ryancblocker/sports-ticker/case/reference/Cheap Yellow Display v16.step

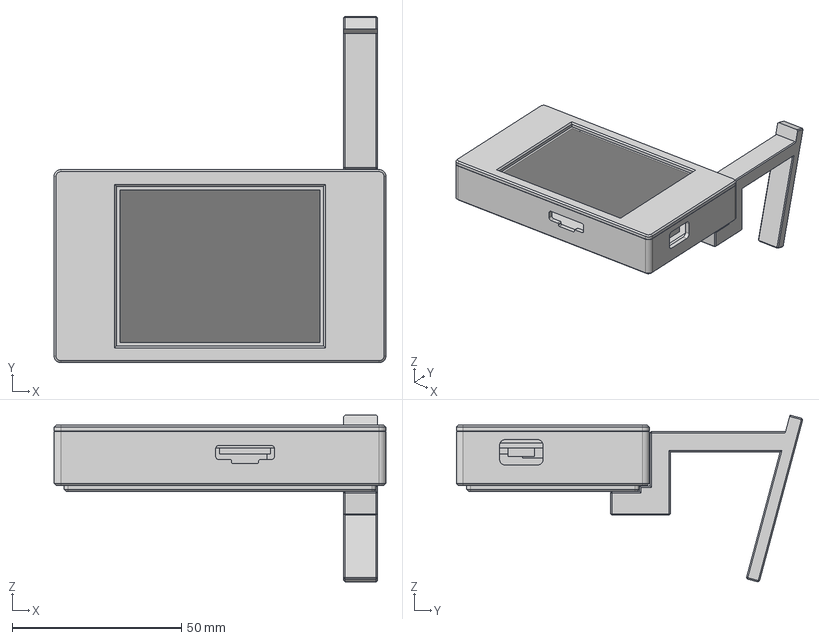
[picture p1: CAD file, 2026-11-10]
case/reference/Cheap Yellow Display v16.step
98.0 x 102.3 x 49.2 mm
Display
case front
case rear
case back panel
case foot
