ryancblocker/sports-ticker/case/stl/SportsTicker_PodBack.stl

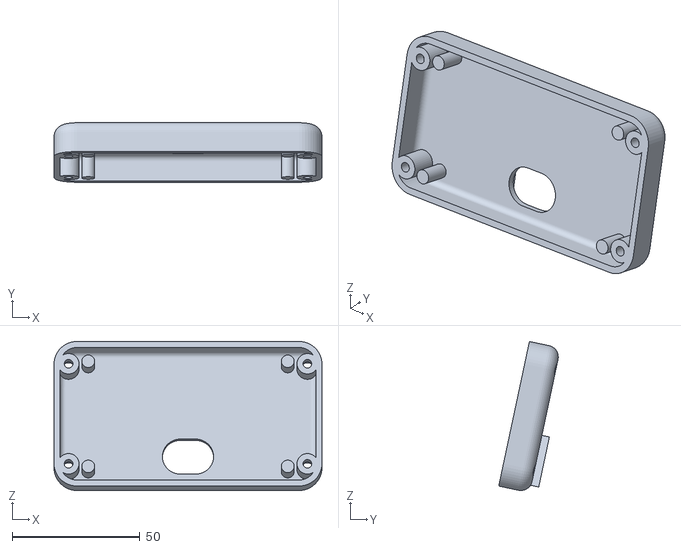
[picture p2: CAD file, 2026-11-10]
case/stl/SportsTicker_PodBack.stl
104.8 x 23.3 x 58.3
