ryancblocker/sports-ticker/makerworld/SportsTickerFinal.3mf

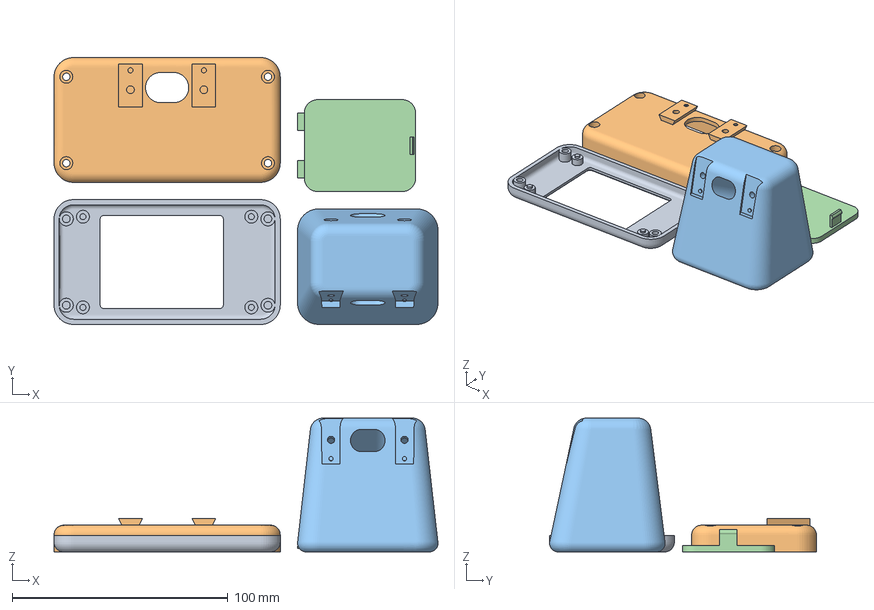
[picture p3: CAD file, 2026-11-10]
makerworld/SportsTickerFinal.3mf
177.8 x 123.6 x 62.0 mm
Pod Front (face down)
Pod Back (rails up)
Base (upright)
Penny Lid
