ryancblocker/sports-ticker/SportsTickerFinal.3mf

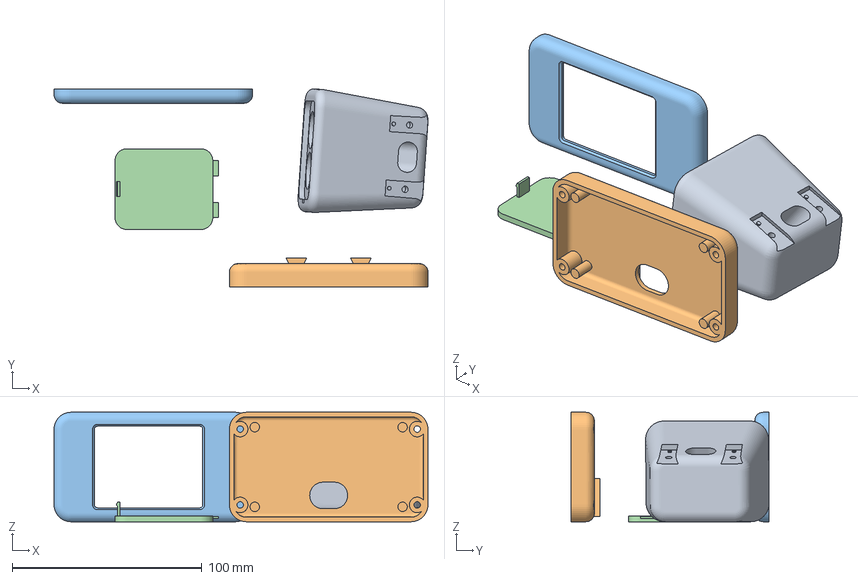
[picture p4: CAD file, 2026-11-10]
SportsTickerFinal.3mf
197.3 x 104.6 x 57.8 mm
Base (upright)
Pod Back (rails up)
Pod Front (face down)
Penny Lid
