ryancblocker/sports-ticker/case/stl/SportsTicker_Base.stl

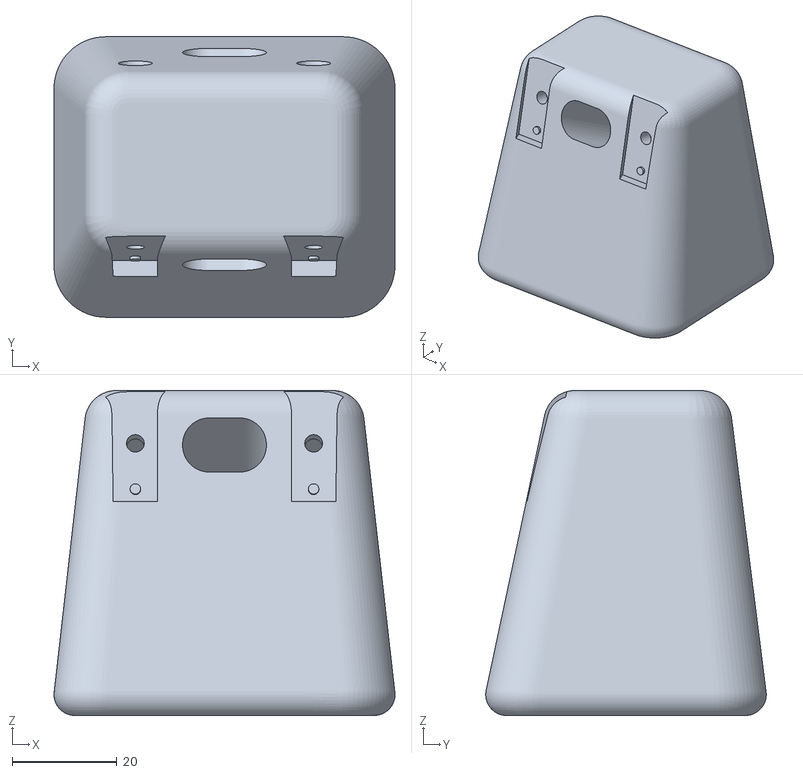
[picture p5: CAD file, 2026-11-10]
case/stl/SportsTicker_Base.stl
65.0 x 53.5 x 62.0
