ryancblocker/sports-ticker/test-print/SportsTicker_BaseAndLid.3mf

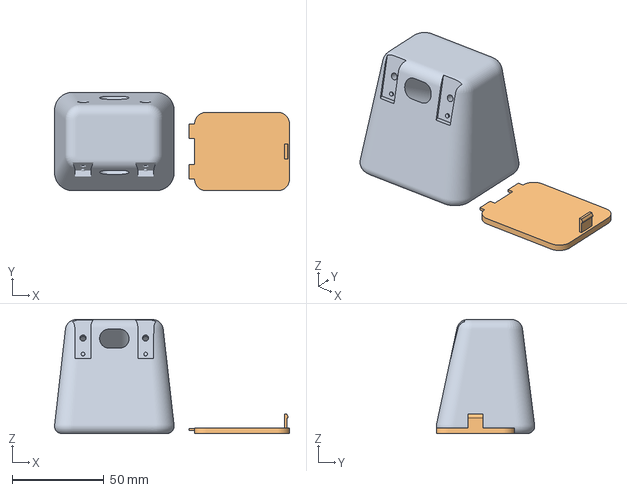
[picture p6: CAD file, 2026-11-10]
test-print/SportsTicker_BaseAndLid.3mf
127.7 x 53.5 x 62.0 mm
Base (upright)
Penny Lid
