ryancblocker/sports-ticker/case/stl/SportsTicker_PodFront.stl

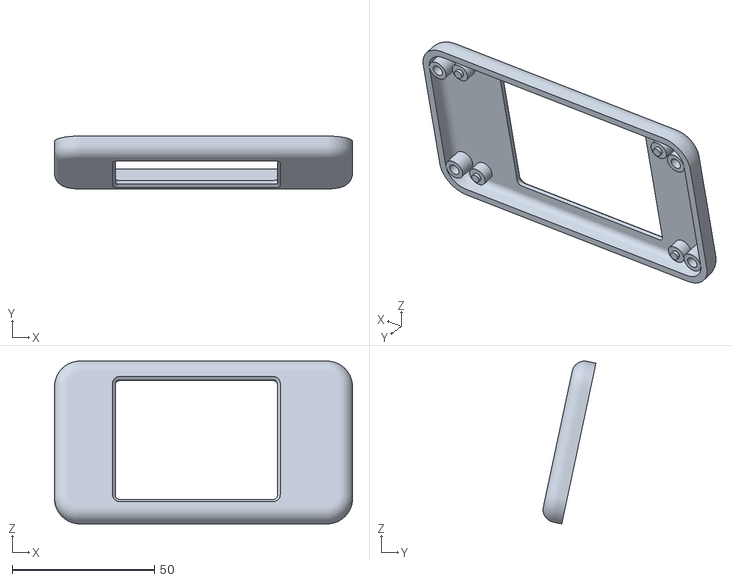
[picture p7: CAD file, 2026-11-10]
case/stl/SportsTicker_PodFront.stl
104.8 x 18.6 x 57.3
