ryancblocker/sports-ticker/case/stl/SportsTicker_PennyLid.stl

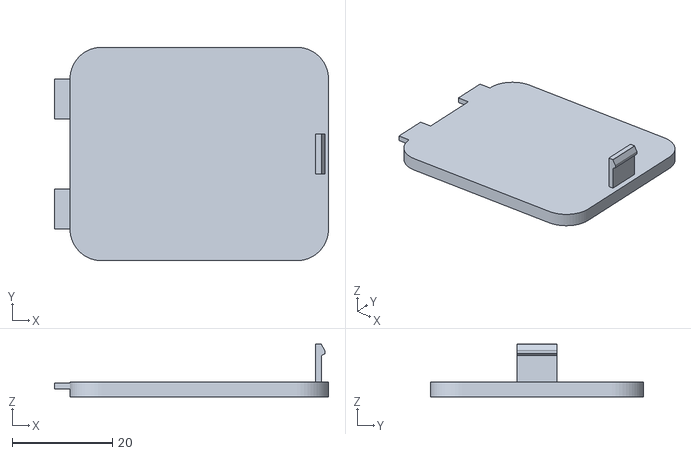
[picture p8: CAD file, 2026-11-10]
case/stl/SportsTicker_PennyLid.stl
54.7 x 42.6 x 10.5
