ryancblocker/sports-ticker/(list of files, cad)

Other CAD files:
case/reference/Cheap Yellow Display v16.f3d
