ryancblocker/sports-ticker/makerworld/images/00_cover_title_3x4.png

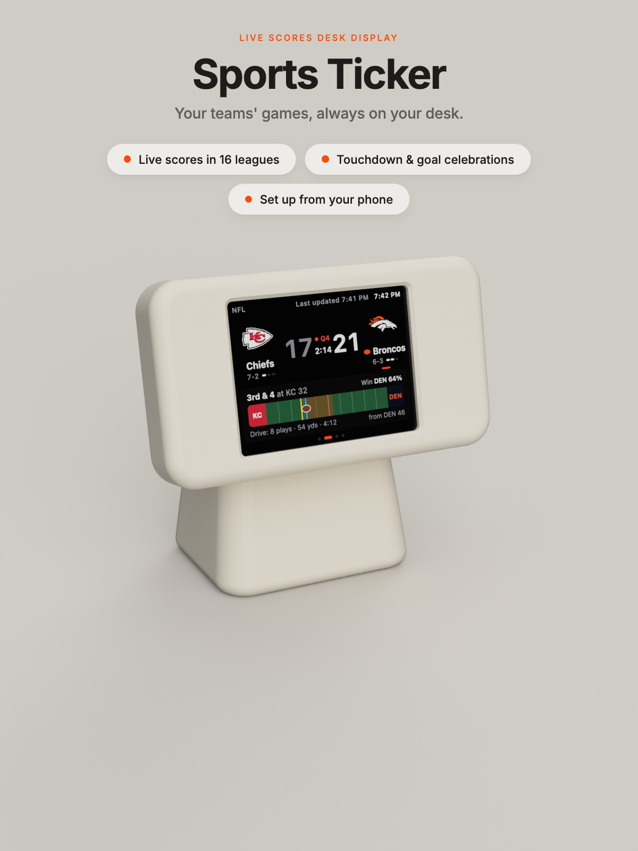
makerworld/images/00_cover_title_3x4.png
