ryancblocker/sports-ticker/makerworld/images/00_cover_title_4x3.png

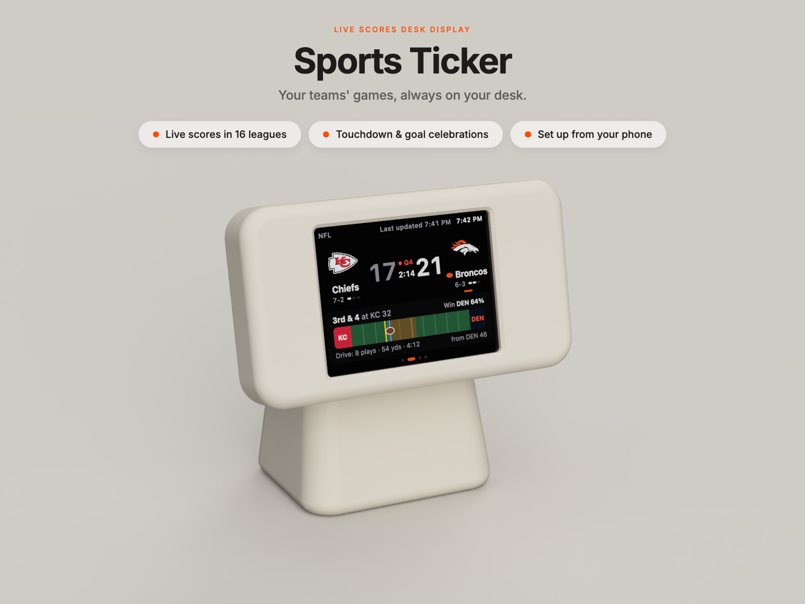
makerworld/images/00_cover_title_4x3.png
