ryancblocker/sports-ticker/makerworld/images/00_group_3x4.png

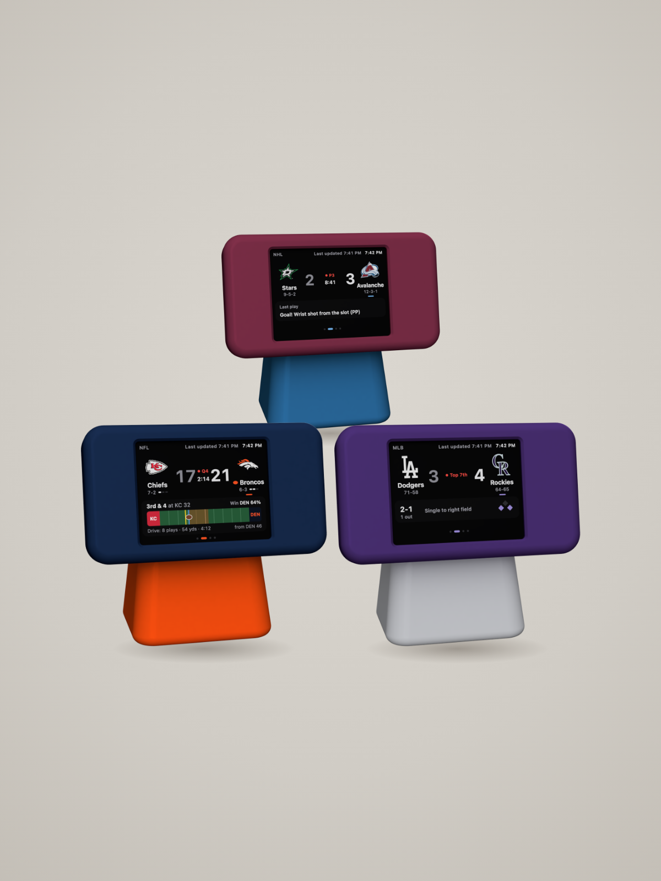
makerworld/images/00_group_3x4.png
