ryancblocker/sports-ticker/makerworld/images/00_group_4x3.png

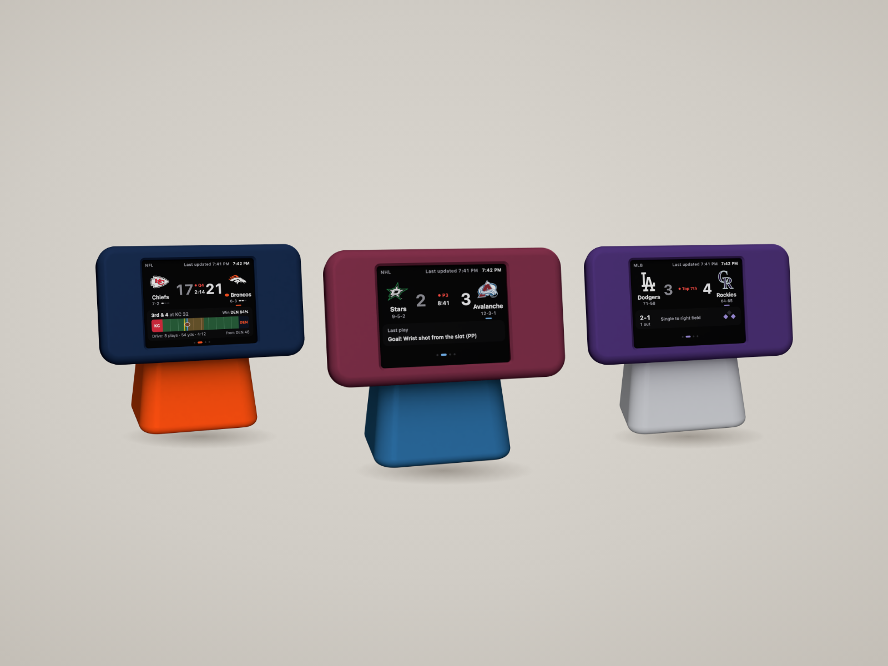
makerworld/images/00_group_4x3.png
