ryancblocker/sports-ticker/makerworld/images/01_hero_3x4.png

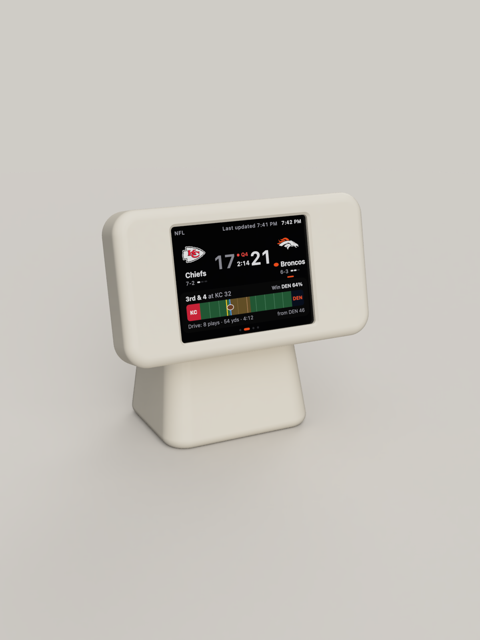
makerworld/images/01_hero_3x4.png
