ryancblocker/sports-ticker/makerworld/images/01_hero_4x3.png

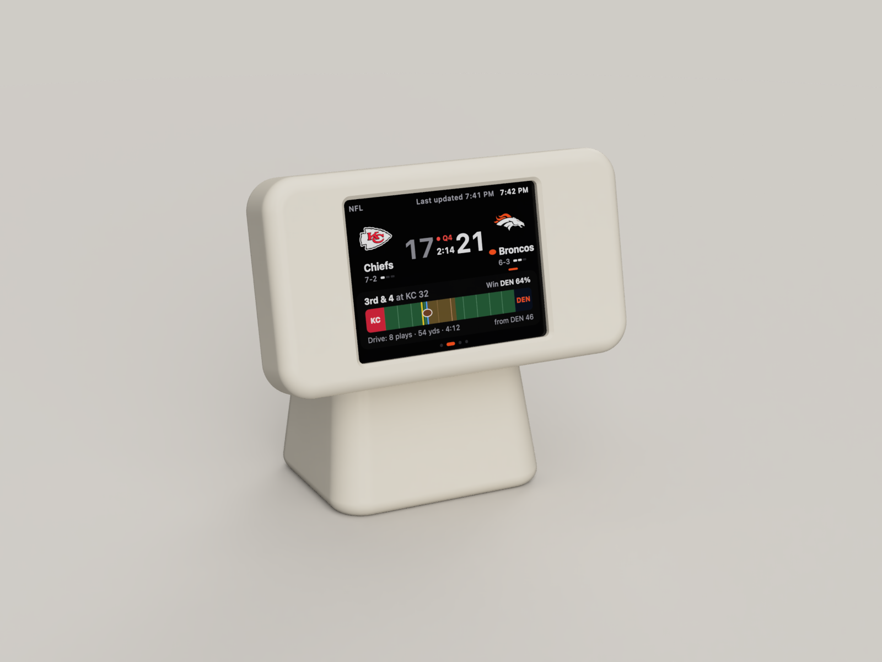
makerworld/images/01_hero_4x3.png
