ryancblocker/sports-ticker/makerworld/images/02_front_3x4.png

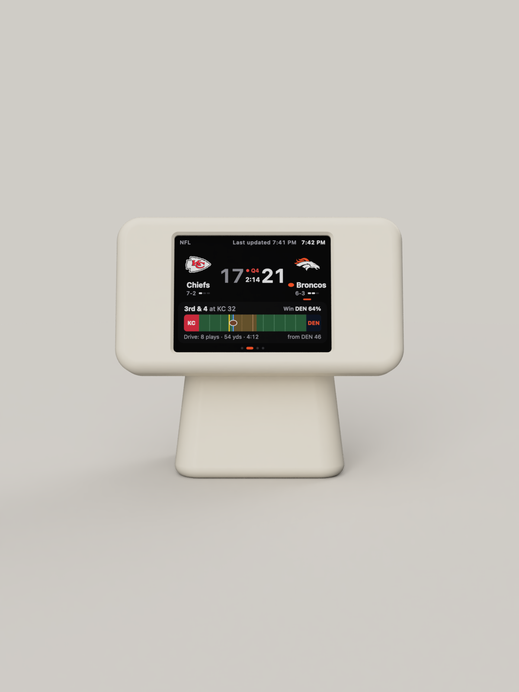
makerworld/images/02_front_3x4.png
