ryancblocker/sports-ticker/makerworld/images/02_front_4x3.png

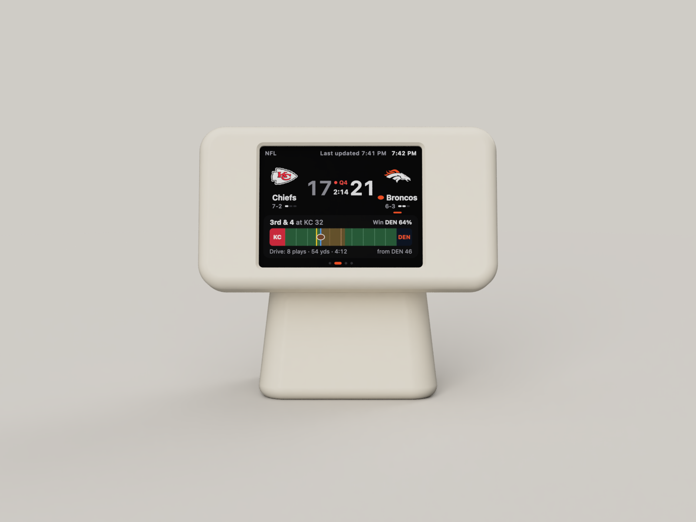
makerworld/images/02_front_4x3.png
