ryancblocker/sports-ticker/makerworld/images/03_side_3x4.png

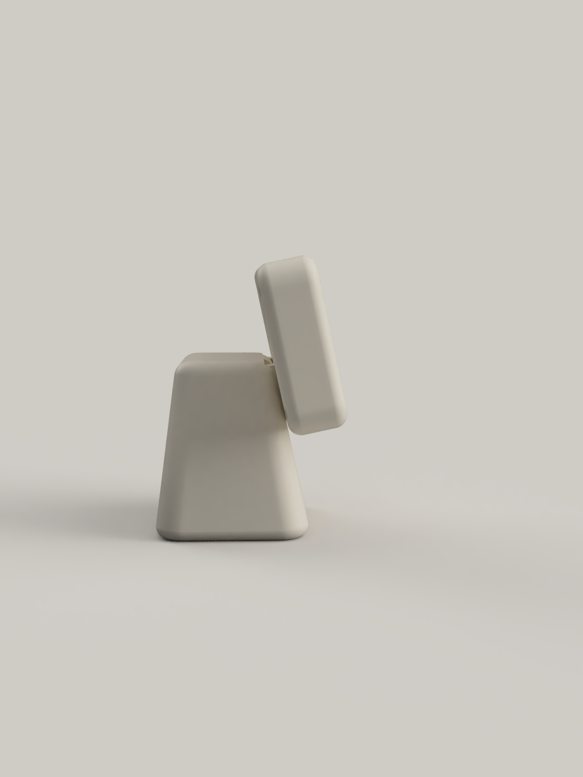
makerworld/images/03_side_3x4.png
