ryancblocker/sports-ticker/makerworld/images/03_side_4x3.png

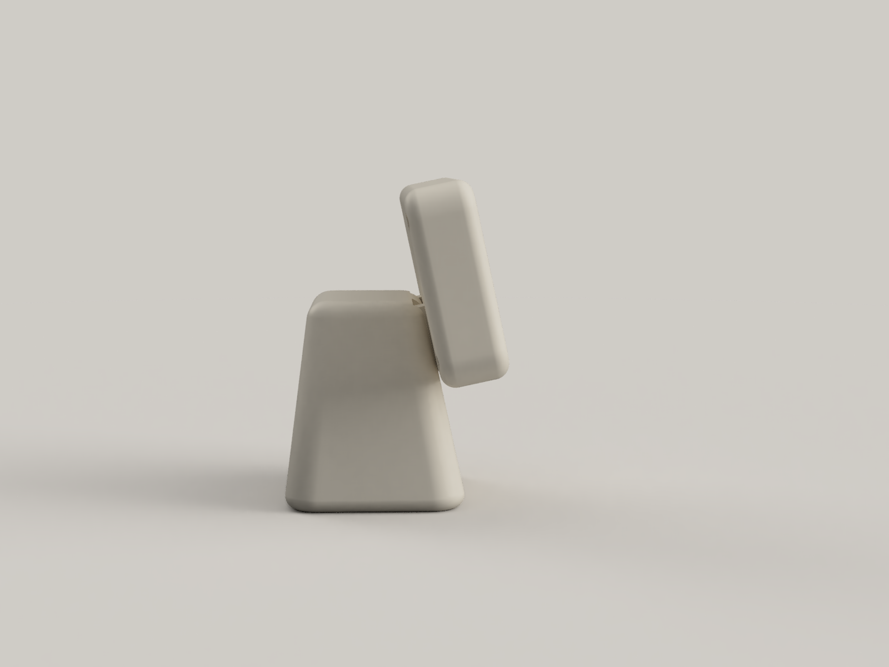
makerworld/images/03_side_4x3.png
