ryancblocker/sports-ticker/makerworld/images/04_back_3x4.png

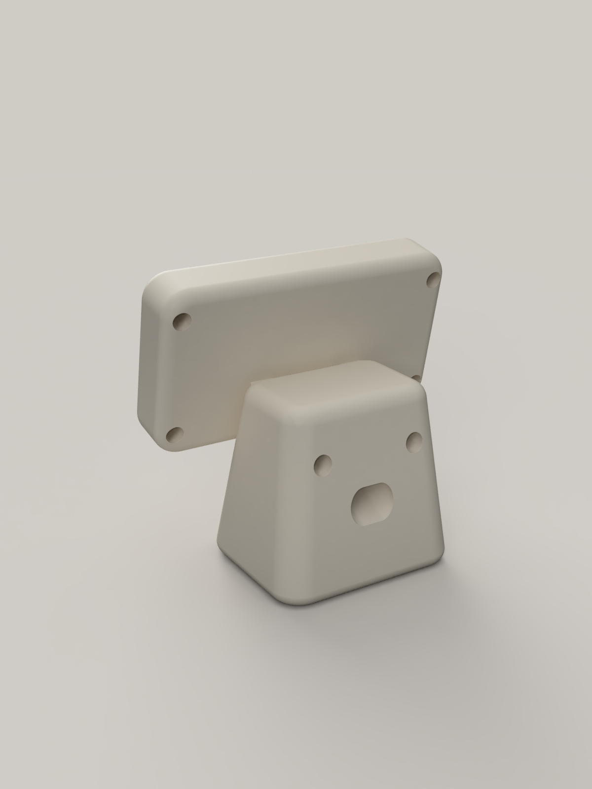
makerworld/images/04_back_3x4.png
