ryancblocker/sports-ticker/makerworld/images/04_back_4x3.png

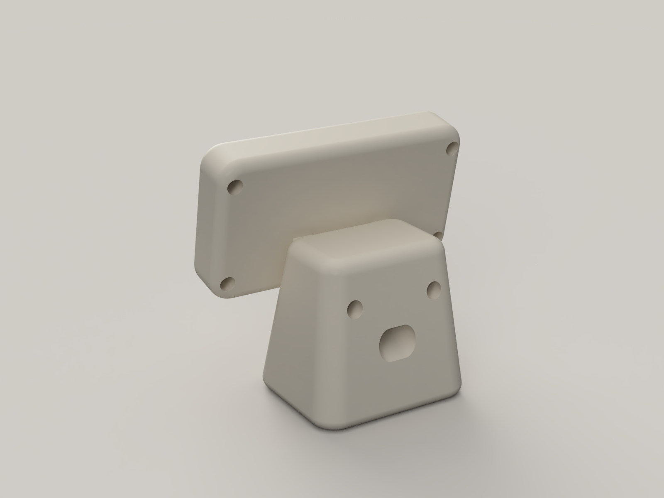
makerworld/images/04_back_4x3.png
