ryancblocker/sports-ticker/makerworld/images/05_hockey_3x4.png

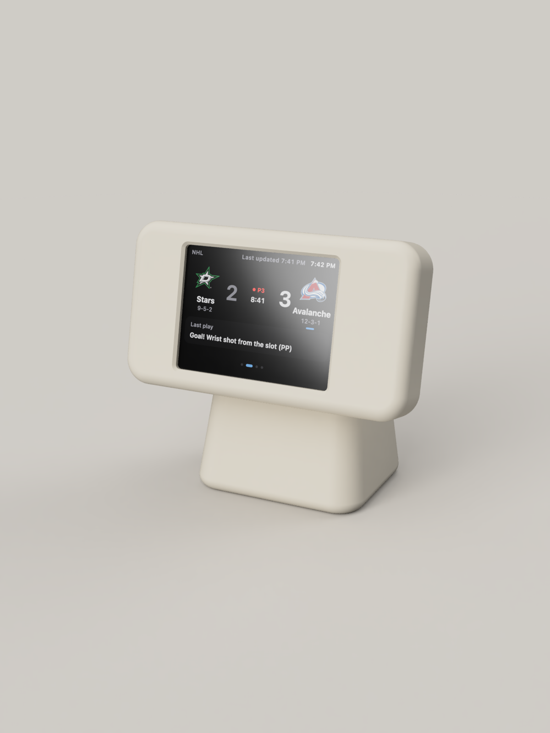
makerworld/images/05_hockey_3x4.png
