ryancblocker/sports-ticker/makerworld/images/05_hockey_4x3.png

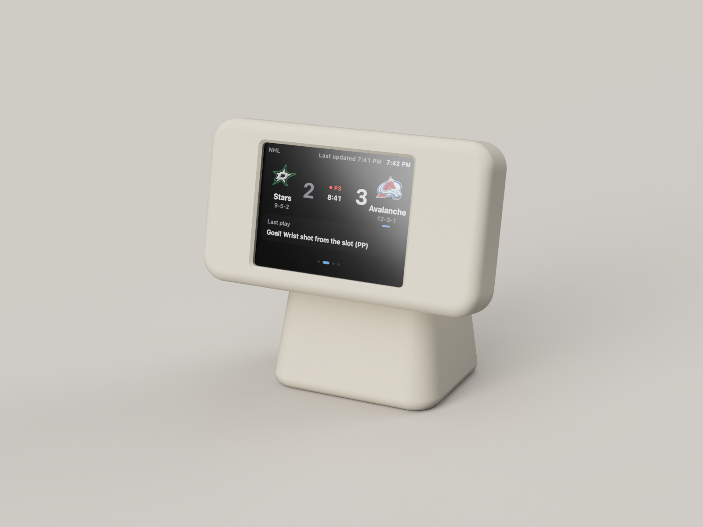
makerworld/images/05_hockey_4x3.png
