ryancblocker/sports-ticker/makerworld/images/06_baseball_3x4.png

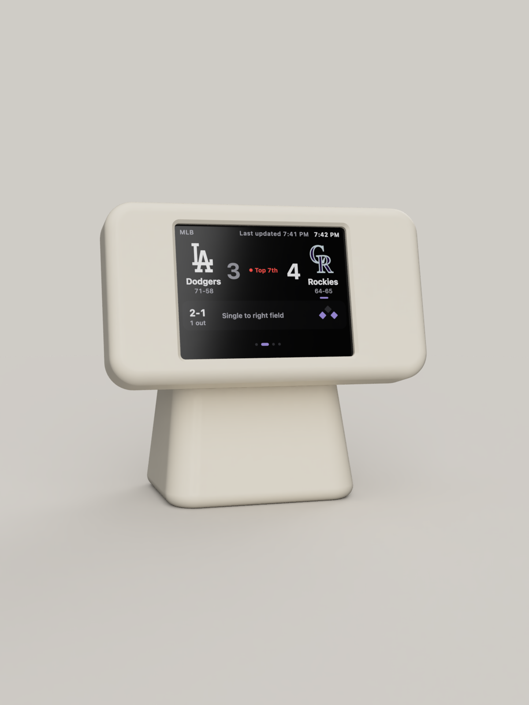
makerworld/images/06_baseball_3x4.png
