ryancblocker/sports-ticker/makerworld/images/06_baseball_4x3.png

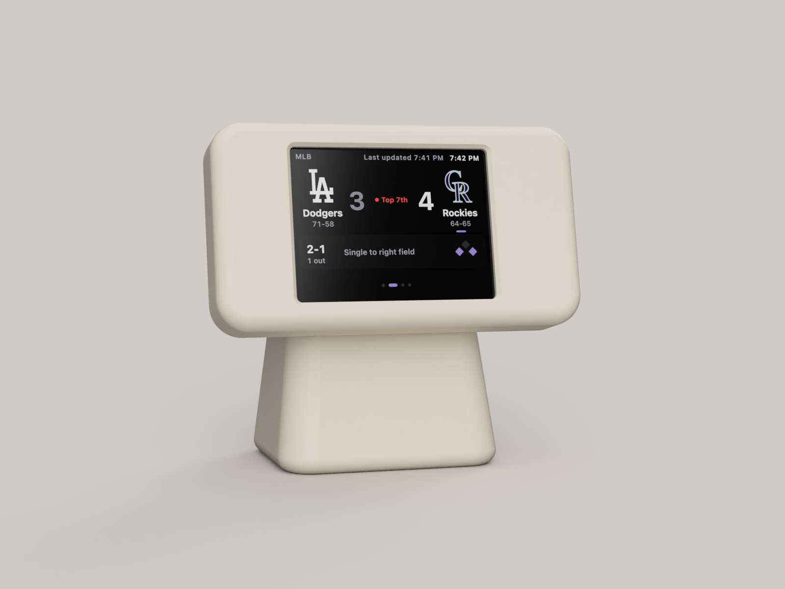
makerworld/images/06_baseball_4x3.png
