ryancblocker/sports-ticker/firmware/src/lgfx_cyd.h

// LovyanGFX configuration for the ESP32-2432S028 ("Cheap Yellow Display").
//   Display : ILI9341 (or ST7789 on the 2-USB revision) on HSPI
//   Touch   : XPT2046 resistive on its own SPI pins (VSPI)
#pragma once
#define LGFX_USE_V1
#include <LovyanGFX.hpp>

class LGFX : public lgfx::LGFX_Device {
#ifdef CYD_ST7789
  lgfx::Panel_ST7789 _panel;
#else
  lgfx::Panel_ILI9341 _panel;
#endif
  lgfx::Bus_SPI _bus;
  lgfx::Light_PWM _light;
  lgfx::Touch_XPT2046 _touch;

 public:
  LGFX() {
    {
      auto cfg = _bus.config();
      cfg.spi_host = HSPI_HOST;
      cfg.spi_mode = 0;
      cfg.freq_write = 40000000;
      cfg.freq_read = 16000000;
      cfg.spi_3wire = false;
      cfg.use_lock = true;
      cfg.dma_channel = SPI_DMA_CH_AUTO;
      cfg.pin_sclk = 14;
      cfg.pin_mosi = 13;
      cfg.pin_miso = 12;
      cfg.pin_dc = 2;
      _bus.config(cfg);
      _panel.setBus(&_bus);
    }
    {
      auto cfg = _panel.config();
      cfg.pin_cs = 15;
      cfg.pin_rst = -1;
      cfg.pin_busy = -1;
      cfg.panel_width = 240;
      cfg.panel_height = 320;
      cfg.offset_x = 0;
      cfg.offset_y = 0;
      cfg.offset_rotation = 0;
      cfg.dummy_read_pixel = 8;
      cfg.dummy_read_bits = 1;
      cfg.readable = true;
#ifdef CYD_ST7789
      cfg.invert = true;
#else
      cfg.invert = false;
#endif
      cfg.rgb_order = false;
      cfg.dlen_16bit = false;
      cfg.bus_shared = false;
      _panel.config(cfg);
    }
    {
      auto cfg = _light.config();
      cfg.pin_bl = 21;
      cfg.invert = false;
      cfg.freq = 44100;
      cfg.pwm_channel = 7;
      _light.config(cfg);
      _panel.setLight(&_light);
    }
    {
      auto cfg = _touch.config();
      cfg.x_min = 300;
      cfg.x_max = 3900;
      cfg.y_min = 200;
      cfg.y_max = 3700;
      cfg.pin_int = 36;
      cfg.bus_shared = false;
      cfg.offset_rotation = 0;
      cfg.spi_host = VSPI_HOST;
      cfg.freq = 1000000;
      cfg.pin_sclk = 25;
      cfg.pin_mosi = 32;
      cfg.pin_miso = 39;
      cfg.pin_cs = 33;
      _touch.config(cfg);
      _panel.setTouch(&_touch);
    }
    setPanel(&_panel);
  }
};
