ryancblocker/sports-ticker/(commit log)

2026-11-10 Sports Ticker: ESP32 CYD live-scores ticker firmware and desk stand
    Firmware (PlatformIO), phone config page, Fusion 360 stand generator,
    STL/3MF print files and MakerWorld listing assets.
    [Cheap Yellow Display v16.f3d, Cheap Yellow Display v16.step, SportsTickerFinal.3mf, SportsTicker_Base.stl, SportsTicker_BaseAndLid.3mf, SportsTicker_PennyLid.stl, SportsTicker_PodBack.stl, SportsTicker_PodFront.stl]
2026-11-10 MakerWorld listing: parts and print settings as lists instead of tables
2026-11-13 platformio: default to the cyd env so a bare upload flashes one board
